SolarEnergyRacers/solar_car_control_system/data/README.md

## TODO: add description

### SER4 
// TODO

### Motor
// TODO
