SolarEnergyRacers/solar_car_control_system/data/motor/README.md

### Motor Efficiency Data

#### Naming
`xxxRyyV.csv` where `xxx=round per minutes`, `yy=voltage`

#### Torque
The test has been conducted at a constant torque of 12Nm (corresponding to approx 70km/h @ 1kW)
