SolarEnergyRacers/solar_car_control_system/docs/electroCad/README.md

# ELT-Schema and Board Design

[toc]

## Open Questions

- [ ] Do we need 5V and 3.3V on Main board?
- [ ] Should we provide additional 5V to Steering-wheel board (brightness)?
- [ ] Do we need one or two CAN bus transceivers?
- [ ] The new designed elements (PCF, ADS) and other parts need to add a footprint in library

## Rules and Hints

- all new for SER4 designed elements should get the tag "SER4"

## Main-board

### Layout Idea

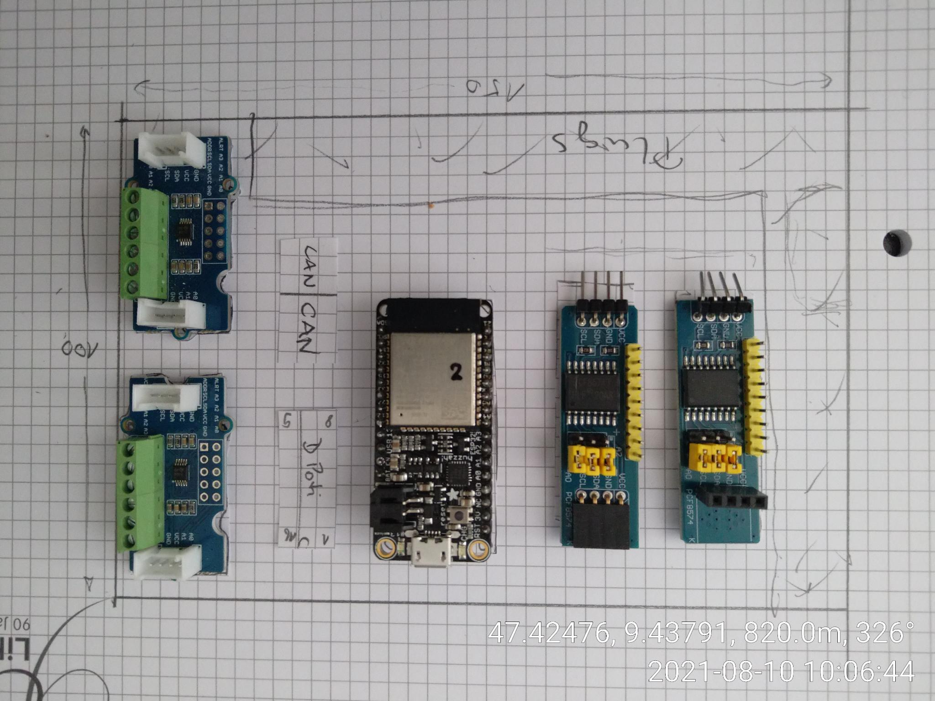
[picture p2: docs/electroCad/assets.README/mount1.png]
mount1
- Board 150x100

- --> The IO and ADC board are stripped of of all connectors and reassembled, see below) mount2

To change connectors:

- PCF8574 boards
  - remove all plugs
  - reassembly 9 pin plug (8 IOs and Interrupt) and 4 pin I2C pin (I2C) on backside
  - can possibly be shortened a little
  - drill mounting hole
- ADS1115 grove boards
  - remove all plugs and connectors
  - reassembly 4 pins (analog in) and 4 pins (I2C) on backside
- CAN
  - IC names missing in doc/data-sheets

## Steering-wheel Board
