SolarEnergyRacers/solar_car_control_system/docs/HC-12--Serial-Console.md

# HC-12 Serial Radio Console

## Description

- [Understanding and Implementing the HC-12](https://www.allaboutcircuits.com/projects/understanding-and-implementing-the-hc-12-wireless-transceiver-module/)

## Testcode

Download to both ESP32 mit connected HC-12.

```C++
#include <Streaming.h>
#include <SoftwareSerial.h>

//#define RXD 14
//#define TXD 15
#define RXD2 16
#define TXD2 17

void setup() {

  Serial.begin(115200);
  delay(1000);

  Serial << endl;
  Serial << "--------------------" << endl;
  Serial << "esp32dev + free RTOS" << endl;
  Serial << "Solar Energy Car Races SER4" << 1 << " -- " << "24.12.1924" << endl;
  Serial << "--------------------" << endl;

  Serial.println("Serial TX0 is on pin: " + String(TX));
  Serial.println("Serial RX0 is on pin: " + String(RX));

  Serial.println("Serial TX2 is on pin: " + String(TXD2));
  Serial.println("Serial RX2 is on pin:  " + String(RXD2));

  Serial2.begin(9600, SERIAL_8N1, RXD2, TXD2);
  delay(500);
  Serial2 << endl;
  Serial2 << "--------------------" << endl;
  Serial2 << "esp32dev + free RTOS" << endl;
  Serial2 << "Solar Energy Car Races SER4" << 1 << " -- " << "24.12.1924" << endl;
  Serial2 << "--------------------" << endl;

}

bool payload;
void loop() {
  payload = false;
  while (Serial2.available()) {
    Serial.print(char(Serial2.read()));
    payload = true;
  }

  String buffer = Serial.readString();

  if ( buffer.length() > 0)
    Serial2 << buffer << " -- sent!" << endl;
  delay(100);
}

```
