SolarEnergyRacers/solar_car_control_system/docs/adafruit-ltc4311-i2c-extender-active-terminator.md

# LTC4311 - I2C Extender and Active Terminator

https://learn.adafruit.com/adafruit-ltc4311-i2c-extender-active-terminator
