SolarEnergyRacers/solar_car_control_system/regulations/ReviewRegulations.md

# Review Regulations WSC, ASC

## ASC2024-Regs-EXTERNAL-RELEASE-A.pdf  (2024)
### 8.1. Sollar Collector (Jonas)
### 8.2 Energy Storage (Damian)
### 8.3 Protection Circuits (Karl)
### 8.4. Battery Ennclosures (Damian)
### 8.5. Main Fuse (Jonas)
### 8.6. Power Switch (Jonas)
### 8.7. Cables (Jonas)
### 8.8. Control (Karl)
### 8.9. Electrical Shock Hazard (Andi)

### 9.4. Lighting (Tobias)
### 9.5. E Rear Vision (Damian)
### 10.5. Breakes (Karl)

## ASC2016_Protection-System-Test-Procedure.pdf (Damian, Jonas)

## 2021_bwsc_regulations_release_version_1_19062020.pdf
### 2.4. Solar colector (Jonas)
### 2.18. Rear vision (Damian)
### 2.211 Brakes (Karl)
### 2.24 Lightinh (Tobias)
### 2.25. (Tobias)
### 2.26. (Tobias, Karl)
### 2.27. Automatic functions (Karl)
### 2.28., 2.29 Elactrical saftey, safe state (Jonas)
### 3.8. Communication (Tobias)

### 3.13. Dynamic scrutineering (alle)
