SolarEnergyRacers/solar_car_control_system/docs/ADS1115--ADC0_ADC1_ADC2-infos.md

# ADS1115: 4 Channel Analog-Digital-Converter

- [Buy: e.g. distrrelec](https://www.distrelec.ch/en/ads1115-channel-16-bit-analogue-to-digital-converter-with-programmable-amplifier-gain-seeed-studio-109020041/p/30180590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)
- [Tutorial ###TODO]()

## Pinout and Usage

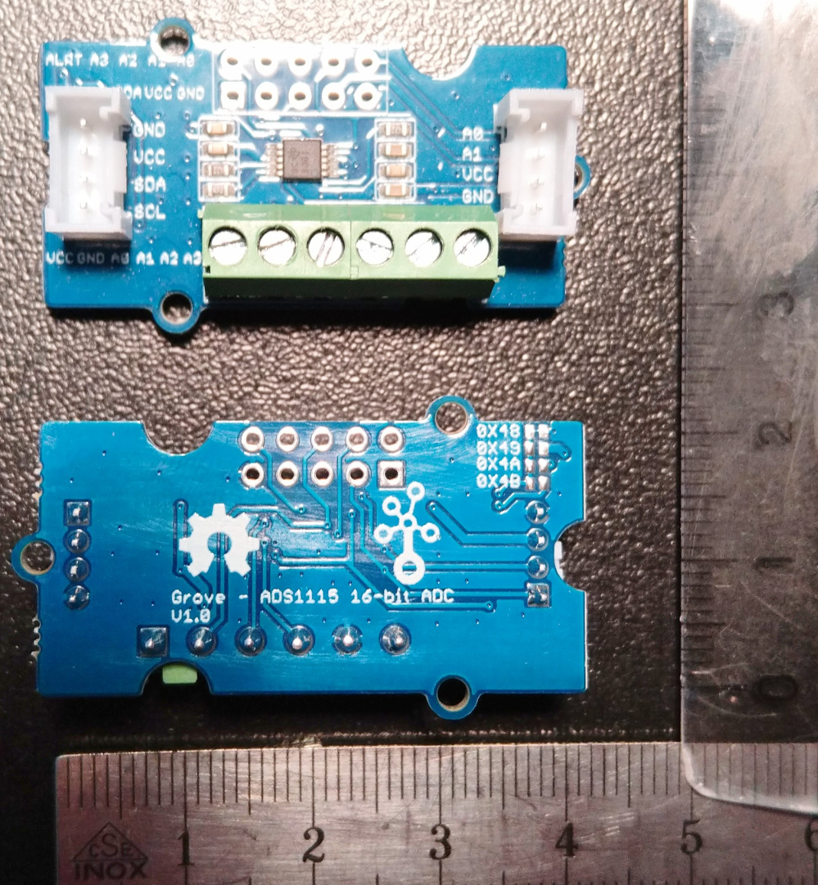
[picture p10: docs/assets.ADS1115--ADC0_ADC1_ADC2-infos/GroveADS1115-front-back.png]
GroveADS1115-front-back


Board size: 42x24, height with jumpers and plugs : 14

Usage in steering wheel:

- 2 analog in from green screw clamp (pin assignment left from screw clamp: VCC | GND | A0 | A1)
- GND, VCC from green screw clamp
- VCC, GND, SDA, SCL from plug

Usage in car hull:

- ###TODO

## Diagram

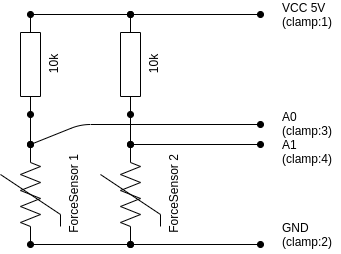
[picture p11: docs/assets.ADS1115--ADC0_ADC1_ADC2-infos/FSR-CurcuitDiagram.drawio.png]


### Board Assembly

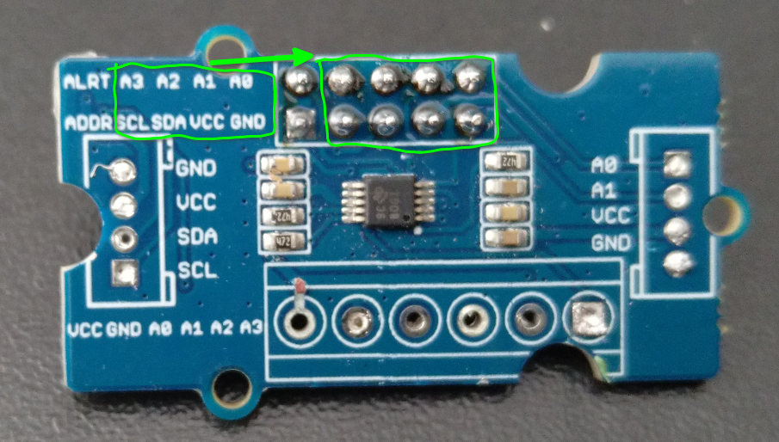
[picture p12: docs/assets.ADS1115--ADC0_ADC1_ADC2-infos/GroveADS1115-usedPins.png]


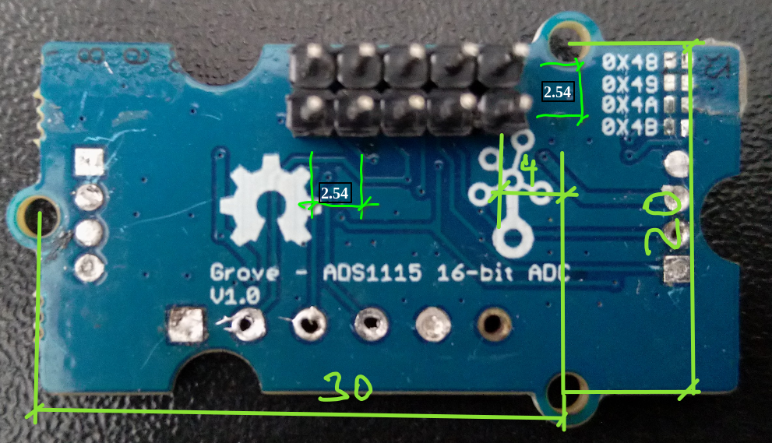
[picture p13: docs/assets.ADS1115--ADC0_ADC1_ADC2-infos/GroveADS1115-rastersize.png]


## Hints and Discussion

- [ ] May be we can desolder the screw clamp and the plugs and use smaller plugs or soldered wires
