SolarEnergyRacers/solar_car_control_system/docs/PCF8574--IOExt0_IOExt1_IOExt2-infos.md

# PCF8574: 8 bit IO Extender with Interrupt

- [Buy: e.g. amazon](https://www.amazon.de/-/en/Mountaineer-PCF8574-IO-Expansion-Expander-Development/dp/B06W564ZSD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)
- [Tutorial](https://www.instructables.com/PCF8574-GPIO-Extender-With-Arduino-and-NodeMCU/)

## Pinout and Usage

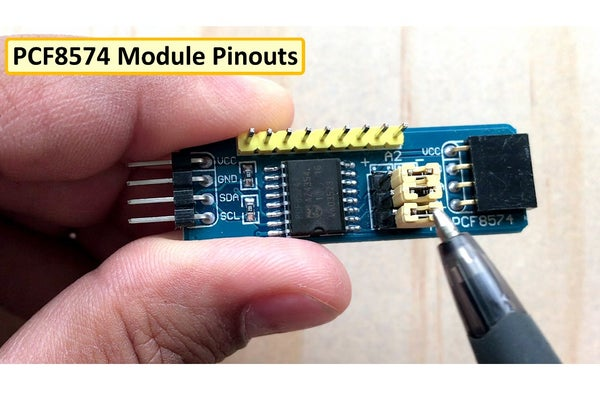
[picture p14: docs/assets.PCF8574--IOExt0_IOExt1_IOExt2-infos/PCF8574-ModulPinout.jpg]


Board size: 49x16, height with jumpers and pins : 11

Usage in steering wheel:

- 8 bits and interrupt from yellow pins (alls PCF8574 can use the same interrupt wire)
- VCC, GND, SDA, SCL from plug (chainable)

Usage in car hull:

- ###TODO

## Daisy-Chain

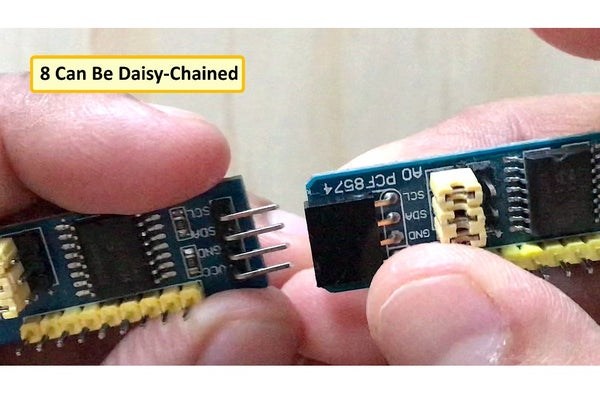
[picture p15: docs/assets.PCF8574--IOExt0_IOExt1_IOExt2-infos/PCF8574-chaining.jpg]


## Diagram

- Push buttons for steering wheel
- GND, VCC, I2C (SDA,SCL), Interrupt

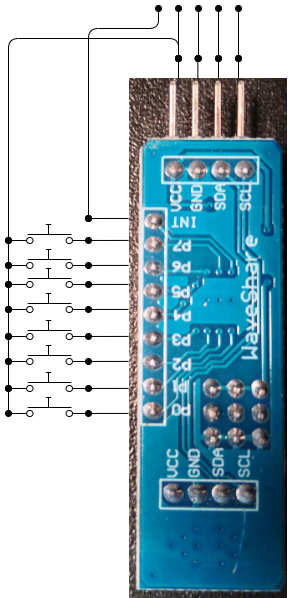
[picture p16: docs/assets.PCF8574--IOExt0_IOExt1_IOExt2-infos/IO-Ext-CurcuitDiagram.drawio.png]


### Board Assembly

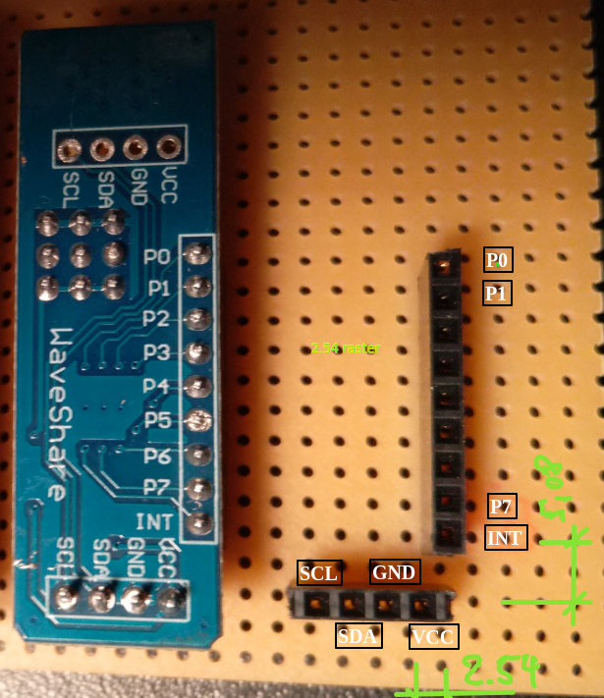
[picture p17: docs/assets.PCF8574--IOExt0_IOExt1_IOExt2-infos/PCF8574-assembly.png]
