SolarEnergyRacers/solar_car_control_system/docs/plug-infos.md

# Plugs

## Steering Wheel connector

15 pin high densitiy plugs

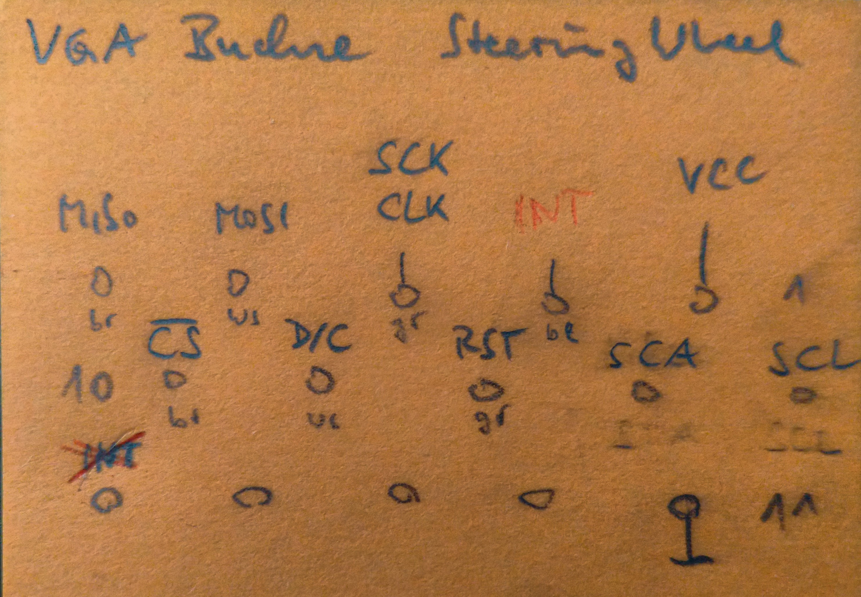
[picture p18: docs/assets.plug-infos/plug-wireing.png]
cc
