SolarEnergyRacers/solar_car_control_system/Impressions.md

# Impressions Old Cars and SER4

## Ser1 - 9m² - Dreirad

## Ser2 - 6m² - Vierrad

## Ser3 - 4m² - Vierrad

Transport
Transportation (Australia: Devils Marbles)

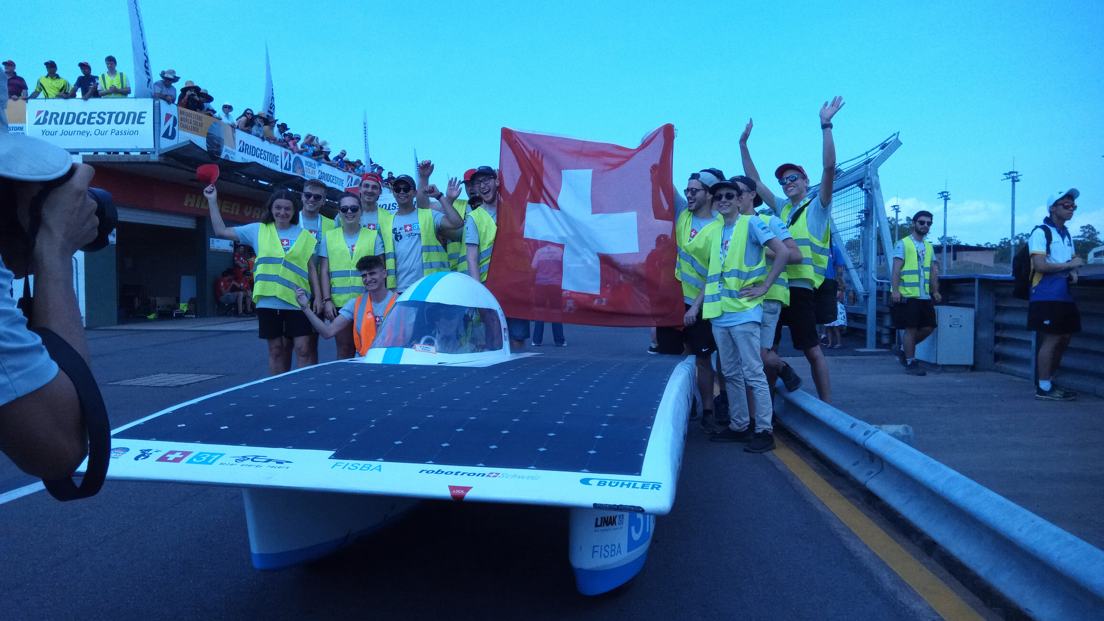
[picture p19: media/Ser3PreStart-2019-10-12.jpg]
Pre Start Peparationa

Car and some team member just before qualifying

Scruteneering
Escape from car in 12s

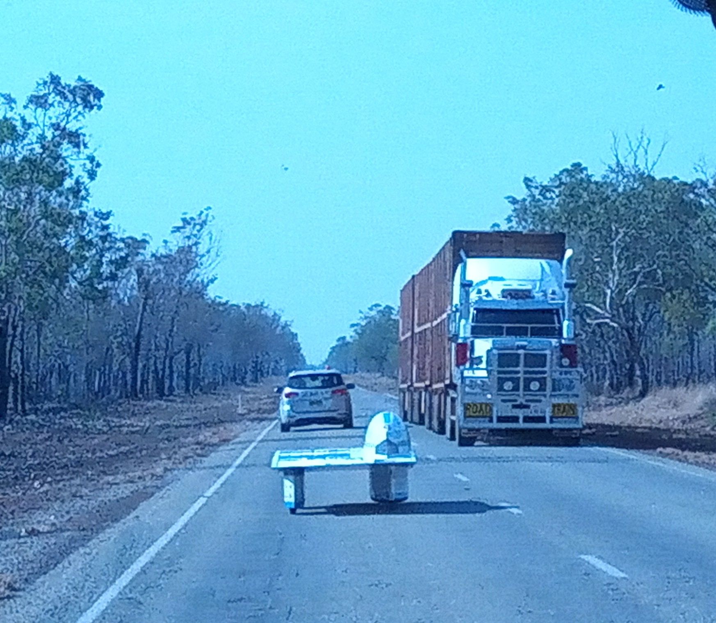
[picture p20: media/Ser3AndRoadTrain_2019-10-14.jpg]
roadTrain

Road Trains in Australia (0.16t against over 100t)

## Ser4 - 4m² - Dreirad

![]()

![]()
