SolarEnergyRacers/solar_car_control_system/docs/assets.DOCU--ILI934-MCP230176-ESP32-Hazzy/ILI9341-wired-fliped.png

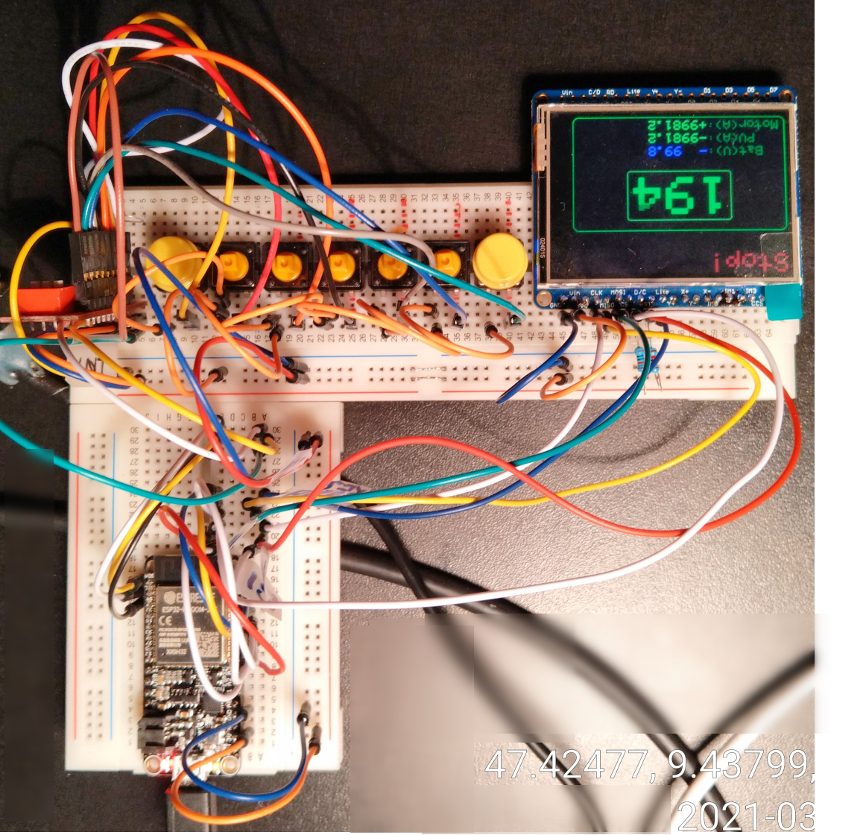
docs/assets.DOCU--ILI934-MCP230176-ESP32-Hazzy/ILI9341-wired-fliped.png
