SolarEnergyRacers/solar_car_control_system/docs/electroCad/signal-2022-05-11-184520_001.jpeg

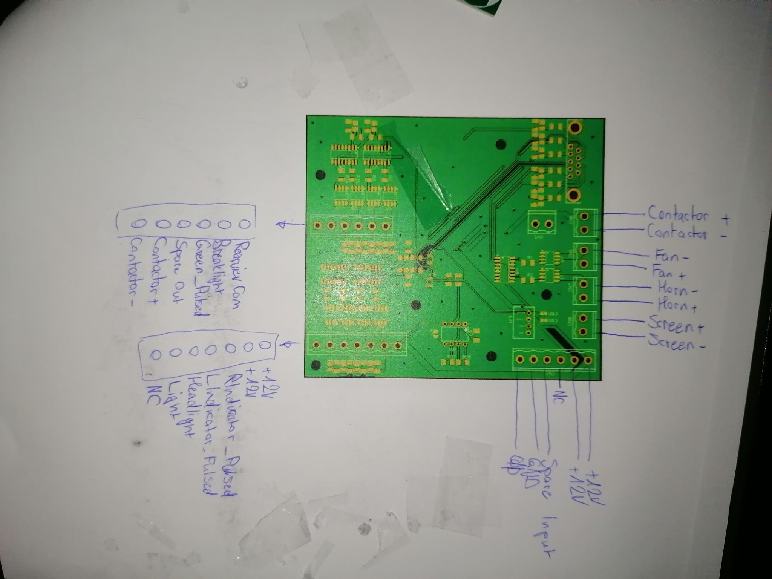
docs/electroCad/signal-2022-05-11-184520_001.jpeg
