SolarEnergyRacers/solar_car_control_system/docs/ser4-drivers-manual.md

# SER4 Drivers Manual

## Preparation

## Control Elements

### Mainboard

(nothing to do by the driver)

### Emergency Controls

### Switch Board

### Steering Wheel

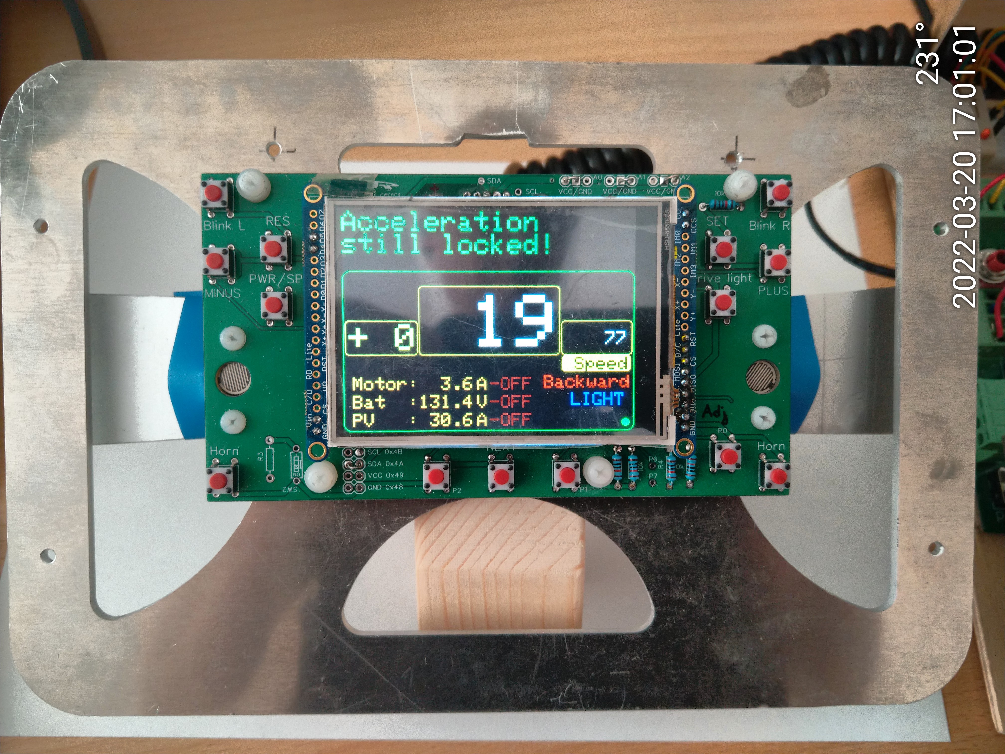
[picture p23: docs/assets.ser4-drivers-manual/SteeringWheel-22022.03.20.jpg]
steeringwheel


## Car Start

### Boot Screen

The bootscrren with blue font on yellow background shows the initialisation of all devices controlled by the car control system.

The first part shows the device init, the second part shows the control task creation.

The last display is a 4 Seconds countdown to allow an additional view to the values.

### Adjust Paddles

After each start the Paddles must be adjusted. Until that the acceleration is locked. It is shown by the number `-99` in the `acceleration/deceleration` display and the drivers information Acceleration still locked.

Procedure:

- Press Button `ADJ`
- Move both paddles at same time slow from min to max to min.
  You have about 5s time for that.
- If successful the `acceleration/deceleration` display show `+ 0`
  Otherwise repeat the complete procedure

## Car Operate

## Steering Wheel

### Buttons

### Paddles

### Display
