SolarEnergyRacers/solar_car_control_system/test/u-i-diagrams.ods

Spannung [V] | Strom Black [mA] | Strom White [mA] | Leistung Black[mW] | Leistung White [mW]
3.05 | 25 | 24 | 75 | 72
3.3 | 30 | 29 | 99 | 96
3.8 | 54 | 53 | 205 | 201
4 | 63 | 62 | 252 | 248
5 | 83 | 80 | 415 | 400
