SolarEnergyRacers/solar_car_control_system/(threads)

Thread 1 (2021-02-02):

Add UART support

andreaskuster, 2021-02-02:
Doc about ESP32 UART module: https://docs.espressif.com/projects/esp-idf/en/v4.0/api-reference/peripherals/uart.html

We might want to use [SoftwareSerial](https://www.arduino.cc/en/Reference/softwareSerial) instead? (simpler interaction)

andreaskuster, 2021-04-12:
The ESP32 equivalent to SoftwareSerial is: https://github.com/jdollar/espsoftwareserial

Closed 2021-04-18.

Thread 3 (2021-02-02):

Add SPI support

andreaskuster, 2021-02-02:
Doc about the ESP32 SPI modules: https://docs.espressif.com/projects/esp-idf/en/v4.0/api-reference/peripherals/spi_master.html

andreaskuster, 2021-02-05:
SPI is supported through the [arduino spi library](https://www.arduino.cc/en/Reference/SPI) on pins
```
 * ESP32 SPI
 *
 *  ESP32  - SPI Pin
 *  --------------
 *  VSPI
 *  GPIO23   MOSI
 *  GPIO19   MISO
 *  GPIO18   CLK
 *  GPIO5    CS (first device, can be any GPIO)
 *
 *  HSPI
 *  GPIO13   MOSI
 *  GPIO12   MISO
 *  GPIO14   CLK
 *  GPIO15   CS
```

Closed 2021-02-05.

Thread 4 (2021-02-02):

Add CAN support

andreaskuster, 2021-02-02:
Doc about ESP32 CAN module: https://docs.espressif.com/projects/esp-idf/en/v4.0/api-reference/peripherals/can.html
Library we might want to use: https://github.com/miwagner/ESP32-Arduino-CAN
**Integrate it into Solar-Car-Control-System**

andreaskuster, 2021-09-01:
The CAN setup has been tested to work using `USB-CAN Adapter` (Profinity & microbus) as well as using the `MCP2521 SPI-CAN Adapter` to interface with a MCU (the ESP32 internal CAN hardware hasn't been tested, but should be supported by the library I used i.e. [arduino-CAN](https://github.com/sandeepmistry/arduino-CAN)

However, what is still missing is the correct configuration / assignment of the CAN IDs. This can only be done with Profinity in conjunction with the `USB-Ethernet Bridge`

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

andreaskuster, 2021-09-06:
Basic support has been added.

andreaskuster, 2021-10-03:
@garned
TODO:
- test CAN with MPPT trackers as well
- add software part to decode data packets
-

andreaskuster, 2022-01-11:
Resolved #131

Closed 2022-01-11.

Thread 7 (2021-02-02):

Add ADS1x15 (analog to digital converter) support

andreaskuster, 2021-02-02:
Port libary: https://github.com/adafruit/Adafruit_ADS1X15

andreaskuster, 2021-02-03:
Initial portation done (it works). Some cleanup work as well as making the i2c read/writes thread-safe remains.

Closed 2021-02-03.

Thread 8 (2021-02-02):

Add DS18B20 (1-Wire temperature sensor) support

andreaskuster, 2021-02-02:
Port library: https://github.com/matmunk/DS18B20

andreaskuster, 2021-02-03:
Initial portation done (it works). Some cleanup work as well as making the 1-Wire read/writes thread-safe remains.

Closed 2021-02-03.

Thread 15 (2021-02-03):

Add PCA9685 (16x 12bit PWM output) support

andreaskuster, 2021-02-03:
Port library: https://github.com/adafruit/Adafruit-PWM-Servo-Driver-Library

andreaskuster, 2021-02-03:
The library has been ported and tested. Some cleanup and ensure thread-safety remains.

Closed 2021-02-03.

Thread 17 (2021-02-03):

Add Grove 6 axis accelerometer & gyroscope support

andreaskuster, 2021-02-03:
Port library: https://github.com/Seeed-Studio/Grove_6Axis_Accelerometer_And_Gyroscope_BMI088

andreaskuster, 2021-02-03:
Initial implementation added and tested.

Closed 2021-02-03.

Thread 24 (2021-02-06):

Define final steering wheel layout (inputs / outputs, potentiometers, ..)

andreaskuster, 2021-02-06:
Discussion done, @KarlSchu can you add the steering wheel layout to this repo (and than close this issue)?

Closed 2021-05-16.

Thread 29 (2021-04-06):

Build pipeline is broken

andreaskuster, 2021-04-06:
Problem: The build fails since the dependent branch `idf-release/v4.0` in `https://github.com/espressif/arduino-esp32.git` in https://github.com/SolarEnergyRacers/solar_car_control_system/blob/7639e751cd04a7a1949b778afc328082f6fe04fd/platformio.ini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
has been delete.

Temporary fix: I was able to get fetch the branch through a closed PR: https://github.com/espressif/arduino-esp32/pull/3670
and temporarly serve this files from https://github.com/andreaskuster/arduino-esp32.git#idf-release/v4.0

Closed 2021-04-06.

Thread 36 (2021-04-09):

Circuit boards V2

andreaskuster, 2021-04-09:
TODO:
- ADC: address issue (@KarlSchu )
- IOExt: alternative IC (@KarlSchu )

- labelling: add input/output label (@DAKOFPV )

andreaskuster, 2021-10-03:
Version1: done
Updated version:
- 2 CAN bus plugs (1x MPPT, 1x BMS) for independent plugin

Closed 2021-12-23.

Thread 40 (2021-04-11):

Fix CAN Problems!!!

tomajon1, 2021-04-11:
Write Email to Prohelion

User Manual:
"COMMUNICATIONS
The CAN standard does not specify high-level message protocols. Prohelion devices use a
custom protocol, outlined in the communication specification document for each device.
By default, each device operates at 500 kbits/second and comes programmed from the factory
with a CAN base address that will allow it to work in unison with other Prohelion devices. The
CAN bit rate and base address can be set with the Windows BMS configuration software."

tomajon1, 2021-04-12:
Hi Jonas,

This functionality is not yet in Profinity, you will need to use the old Tritium tools.

Make sure you get the latest versions of BMS Viewer and CAN-Ethernet bridge configuration:

 BMS_Viewer_2_00.exe
 CanBridgeConfigInstaller_2_04.msi

If you run the BMS viewer software:

1.	Setup->BMS Configuration
2.	Change CAN Bitrate to desired rate:

3.
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

4.	Then: Transfer->Save to BMU

The BMU is now running on the new rate but you will have now lost communications so will need to change the rate on the CAN Bridge:

Go to CAN-Ethernet Bridge Configuration:
5.	Change Bit Rate

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

Hit:  Store

And you should now be communicating on the same bitrate.

Kind regards,

Anthony Prior
CEO
M: +61 411 098 131

andreaskuster, 2021-04-25:
@Damian:

(1) read datasheet
(2) set bitrate to 125k
(3) get it working :)
- possible solution: twisted-pair cable
- oscillator debugging

tomajon1, 2021-07-13:
CAN-Ethernet Bridge Configuration does not work on Windows 7

andreaskuster, 2021-09-06:
Solved & PR created.

Closed 2021-09-06.

Thread 52 (2021-04-25):

#### Isolatation between MCU and external HW

andreaskuster, 2021-04-25:
We should add some sort of isolation between the microcontroller and the external component i.e. to prevent damages of the MCU from short circuits/overvoltage, ..

andreaskuster, 2021-05-30:
This? https://www.ti.com/store/ti/en/p/product/?p=TPS25921LD

Thread 57 (2021-05-10):

check if CS of driver display is at the correct processor pin (may be read only)

KarlSchu, 2021-05-10:

Closed 2021-12-23.

Thread 63 (2021-05-16):

Add Ubat voltage sensing

andreaskuster, 2021-05-16:

andreaskuster, 2021-05-16:
Fixed with PR #64

Closed 2021-05-16.

Thread 65 (2021-05-16):

Fix pin conflict: interrupt / CAN

andreaskuster, 2021-05-16:

Closed 2021-10-03.

Thread 67 (2021-05-16):

Setup online prototype: laptop + prototype ESP32 with all parts mounted + teamviewer + camera on

andreaskuster, 2021-05-16:
```
           xxxxxxx
          xx       xx   xxxx
         xx         xxxx   xx
        xx          x      xxxxxxxx
xxxxxxxxx                          xxx
x      xx                             xxx
x                                       xx
xx                www                    x
 xx                                    xxx
  xxxx x                        xxxx xxx
      xxxxxxxxxxxxxxxxxxxxxxxxxxx
       │                                             ┌─────► ┌─────┐
       │                                             │       │     │
   WiFi│                                             │ ┌───► │ HW  │
       │                                             │ │     │     │
       │        PC                                   │ │ ┌─► └─────┘
    ┌──┴───┬───────────┬─────────┐                   │ │ │
    │      │           │         │ ┌────►     ┌──────┴─┴─┴───┐
    │      │           │  Webcam │ │────►     │              │
    │      │           │         │ └────►     │              │
    │ Team │           └─────────┤            │    ESP32     │
    │ viewer      ┌───┐ ┌──────┐ │    USB     │              │
    │      │      |git|+|vscode├─├────────────┤              │
    │      │      └───┘ └──────┘ │            └──────────────┘
    │      │                     │
    │      │                     │
    │      │                     │
    └──────┴─────────────────────┘

```

andreaskuster, 2021-07-04:
@garned @tomajon1 @KarlSchu @DAKOFPV
Whoever is next at BUZ can either try to install the firefox & gecko webdriver, and adjust the script to catch the login html elements:
- https://github.com/SolarEnergyRacers/solar_car_control_system/blob/add_captive_auto_login/extras/automation/captive_portal.py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
- https://github.com/SolarEnergyRacers/solar_car_control_system/blob/add_captive_auto_login/extras/automation/captive_portal.py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
- https://github.com/SolarEnergyRacers/solar_car_control_system/blob/add_captive_auto_login/extras/automation/captive_portal.py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

in the sbb login template, or send me the HTML copy and urls/IPs of the page.

Closed 2021-12-27.

Thread 71 (2021-06-13):

Battery charging

tomajon1, 2021-06-13:
[2021_06_08_iESC_Regulations_release_version_1-1.pdf](https://github.com/SolarEnergyRacers/solar_car_control_system/files/6644346/2021_06_08_iESC_Regulations_release_version_1-1.pdf)

Pages: 19-22 Weight cells and charging
Page: 38 Auxilary battery

Idea:
- from BMS: cable that can trigger  external circuit breaker while charging

- new power supply & charge controller over full system voltage -> use BMS for balancing

--> akt.Stand: 12V-Steuerspannungsrelais schaltet Schütz1 mit 24 Volt, welches das 400V Schütz2 mit  ansteuert

tomajon1, 2021-06-13:
[2021_06_08_iESC_Regulations_release_version_1-1.pdf](https://github.com/SolarEnergyRacers/solar_car_control_system/files/6644343/2021_06_08_iESC_Regulations_release_version_1-1.pdf)
Pages: 19-22 Weight cells and charging
Page: 38 Auxilary battery

Closed 2021-09-12.

Thread 72 (2021-06-17):

Electronic Component Placement (within the Car)

andreaskuster, 2021-06-17:
#### SER-4 Montage Steuerung/Elektrik

Könnt Ihr mal skizzieren, wo Ihr welche elektrischen Komponenten montieren wollt,
und welches mechanische Montagematerial Ihr dafür benötigt (Alu-Flanche u.ä.)

Besten Dank !

garned, 2021-06-20:
Erster Vorschlag:
MC links aussen an den Längsträger und der uC auf die gegenüberliegende Innenseite.

KarlSchu, 2021-06-20:
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

Closed 2021-06-28.

Thread 83 (2021-07-18):

Green position light if car is in uncritical state

KarlSchu, 2021-07-18:

andreaskuster, 2021-08-07:
@KarlSchu
We might even want to go a step further:
- green: ok
- orange/red: problem, maybe a blink code (i.e. for standard issues like over temparature/current/..)

Thread 84 (2021-07-28):

Discuss Singletons in C++:

KarlSchu, 2021-07-28:
static DriverDisplayC *instance() {
    if (!_instance) {
      _instance = new DriverDisplayC();
    }

-> refactor to `extern` & global definition

andreaskuster, 2021-08-07:
@KarlSchu
Any pros/cons?
As far as I can see, this structure only works with a single class instance, right? Is that a problem?

Closed 2021-12-23.

Thread 94 (2021-08-15):

Battery Status Information

andreaskuster, 2021-08-15:
- what information do we need/want on the microcontroller charging screen? (i.e. temp/min,max voltage,...

Closed 2021-09-12.

Thread 99 (2021-08-29):

Zweiter Bildschirm (Laden)

KarlSchu, 2021-08-29:
- PV-Status [On/Off]
- Batt - Status [Ok, Error]
- BMS-Fehler: <text>

- MPPT 1 -3 [A]

- Batterietemp 1-4 [°C], Höchste T [°C]
- Spannungen min, average, max [V]
- Gesamtspannung Batterie
- Strom BMS [A]

Closed 2021-11-14.

Thread 103 (2021-09-05):

Where are the Temp sensors placed?

KarlSchu, 2021-09-05:
- Solarcells (4 parts)
- MotorController (1)
- MPPTs (4 parts)
- Battery are supported from BMS
- ???

Closed 2022-01-30.

Thread 110 (2021-10-16):

Exchange IOExt chip in SW

KarlSchu, 2021-10-16:
a bit nasty right now -> need to have old IOExt (steering wheel) and new one active at the same time)

andreaskuster, 2021-12-27:
@KarlSchu this is done with the newest merged PRs, right?

Closed 2022-01-02.

Thread 111 (2021-10-16):

Add Gyro functions

KarlSchu, 2021-10-16:

andreaskuster, 2022-03-29:
As far as I can see, the gyro and accelerometer are already integrated (only the `CarState` transition is missing), right?

So, is there anything I should do here?

andreaskuster, 2022-03-31:
The was a deadlock present in the library, which has been fixed while refactorization.

Closed 2022-03-31.

Thread 118 (2021-10-26):

Fix SPI two devices initialization error

andreaskuster, 2021-10-26:
-> spi multiplexer?

andreaskuster, 2021-12-27:
Resolved, the issue was a pin placement and some hardware issues (with the integrated SD card slot in the screen, it works)

Closed 2021-12-27.

Thread 125 (2021-12-05):

Adjust analog outputs: use 0 to 1024 (0V - 5V)

KarlSchu, 2021-12-05:
Use full ADC range: 0 to 1024 (0V - 5V)
For paddles: adjust to paddle range to get 0-5V at acceleration (Speed) and recuperation

andreaskuster, 2022-01-02:
see #140

Closed 2022-02-06.

Thread 134 (2021-12-30):

Physically change GPIO36 (input only, but used as an output!!) -> GPIO32

KarlSchu, 2021-12-30:
In the current branch is a changelog.mf file where the changes are described.
Please check "solved" box if overtraken into  electro schema.

@DAKOFPV:
https://github.com/SolarEnergyRacers/solar_car_control_system/blob/feature/adjust-ios/CHANGELOG_HW.md

Closed 2022-01-30.

Thread 135 (2021-12-30):

fix not working acceleration output

KarlSchu, 2021-12-30:
while dec works the acc gives no value: check circuit for break pedal relais

see #140

Closed 2022-01-30.

Thread 136 (2021-12-30):

Fix sporadic Error

KarlSchu, 2021-12-30:
[E][esp32-hal-i2c.c:1438] i2cCheckLineState(): Bus Invalid State, TwoWire() Can't init sda=1, scl=1

andreaskuster, 2021-12-30:
@KarlSchu Maybe pullups would to the trick, see: https://github.com/espressif/arduino-esp32/issues/3079

Thread 138 (2021-12-31):

Speed control should use acceleration and deceleration

KarlSchu, 2021-12-31:
Recently only acceleration is used in speed control PID

-> on hold until battery is ready (for recuperation part)

andreaskuster, 2022-01-02:
Idea:
Add a meta-variable for the PID controller `setpoint`

Pseudocode:
```
if (decelleration > 0){
   setpoint=  - deceleration
} else {
   setpoint = acceleration
}
```

andreaskuster, 2022-01-06:
@KarlSchu I assume this PR  #144 implements what you are looking for?

andreaskuster, 2022-04-08:
Resolved with #173

Closed 2022-04-08.

Thread 139 (2022-01-01):

Review system boot: All devices off after boot!

KarlSchu, 2022-01-01:

andreaskuster, 2022-03-29:
For all non-critical devices, calling the `init()` function should be enough, right?

And for the safety-critical functions: Aren't we doing this `watchdog timer` thing yet? Sure, the intention was for micro controller crashes, but we should get this additional functionality for free, right?

Thread 142 (2022-01-02):

Telemetry Xbee module SW integration

andreaskuster, 2022-01-02:
-> maybe SD card there? no, problem solved with SD+Display

-> Can we use XBee as Serial console? yes, we will do this!

@garned
TODO:
- test uart tranceiver
- range-test

Closed 2022-02-20.

Thread 145 (2022-01-09):

###### Add voltage sensing at cross point (battery, MC, MPPT) via resistor bridge to ADC

KarlSchu, 2022-01-09:
-> for green light indicator
-> mount on external PCB (high voltage) -> Remo

andreaskuster, 2022-01-16:
Also assigned to @Remo

Thread 154 (2022-02-06):

fix BM088 Gyro&Acc interference with other i2c devices

andreaskuster, 2022-02-06:

andreaskuster, 2022-03-28:
@KarlSchu I re-assigned you, since I do not have the whole board and thus cannot reproduce/test it

Thread 156 (2022-02-12):

Show const speed/power in Driver display

KarlSchu, 2022-02-12:
- at const mode on speed and power are measured in stored
- at switch between speed/power mode the speed/power value is measured and the power/speed reset to 0
- at const mode off speed and power are reset to 0

Closed 2022-03-28.

Thread 166 (2022-02-15):

Integrate HC-12 radio module

KarlSchu, 2022-02-15:

andreaskuster, 2022-02-15:
@KarlSchu
A little present for you:
(1) UART Tx/Rx must be twisted on both sides (i.e. Rx <-> Tx and vice versa)
(2) The SET pin must be floating
(3) It is actually pretty easy to use multiple Serial instances in parallel, see code below (for the receiver)
```
#define RXD2 16
#define TXD2 17

void setup() {
  // Note the format for setting a serial port is as follows: Serial2.begin(baud-rate, protocol, RX pin, TX pin);
  Serial.begin(115200);

  Serial2.begin(9600, SERIAL_8N1, RXD2, TXD2);

  Serial.println("Serial TX0 is on pin: "+String(TX));
  Serial.println("Serial RX0 is on pin: "+String(RX));

  Serial.println("Serial TX2 is on pin: "+String(TXD2));
  Serial.println("Serial RX2 is on pin: "+String(RXD2));

}

bool payload;
void loop() {
  payload = false;
  while (Serial2.available()){
    Serial.print(char(Serial2.read()));
    payload = true;
  }

  if(!payload){
      Serial.println("Nothing to process");
  } else {
      Serial.println();
  }
  delay(5000);
}
````

andreaskuster, 2022-02-20:
Notes:
- continuous 5V supply ??
- capacitor on tx side

Thread 184 (2022-04-24):

Ser1 motor cable shorten.

KarlSchu, 2022-04-24:
New plug for data cable.

Thread 186 (2022-05-15):

Gyro Vibrations?

KarlSchu, 2022-05-15:

Thread 192 (2022-06-05):

Redraw PCBs (i2c issues)

garned, 2022-06-05:
