SolarEnergyRacers/solar_car_control_system/docs/Schematic_SER_Main_2021-09-28.pdf

# + SD Card reader

# + RTC

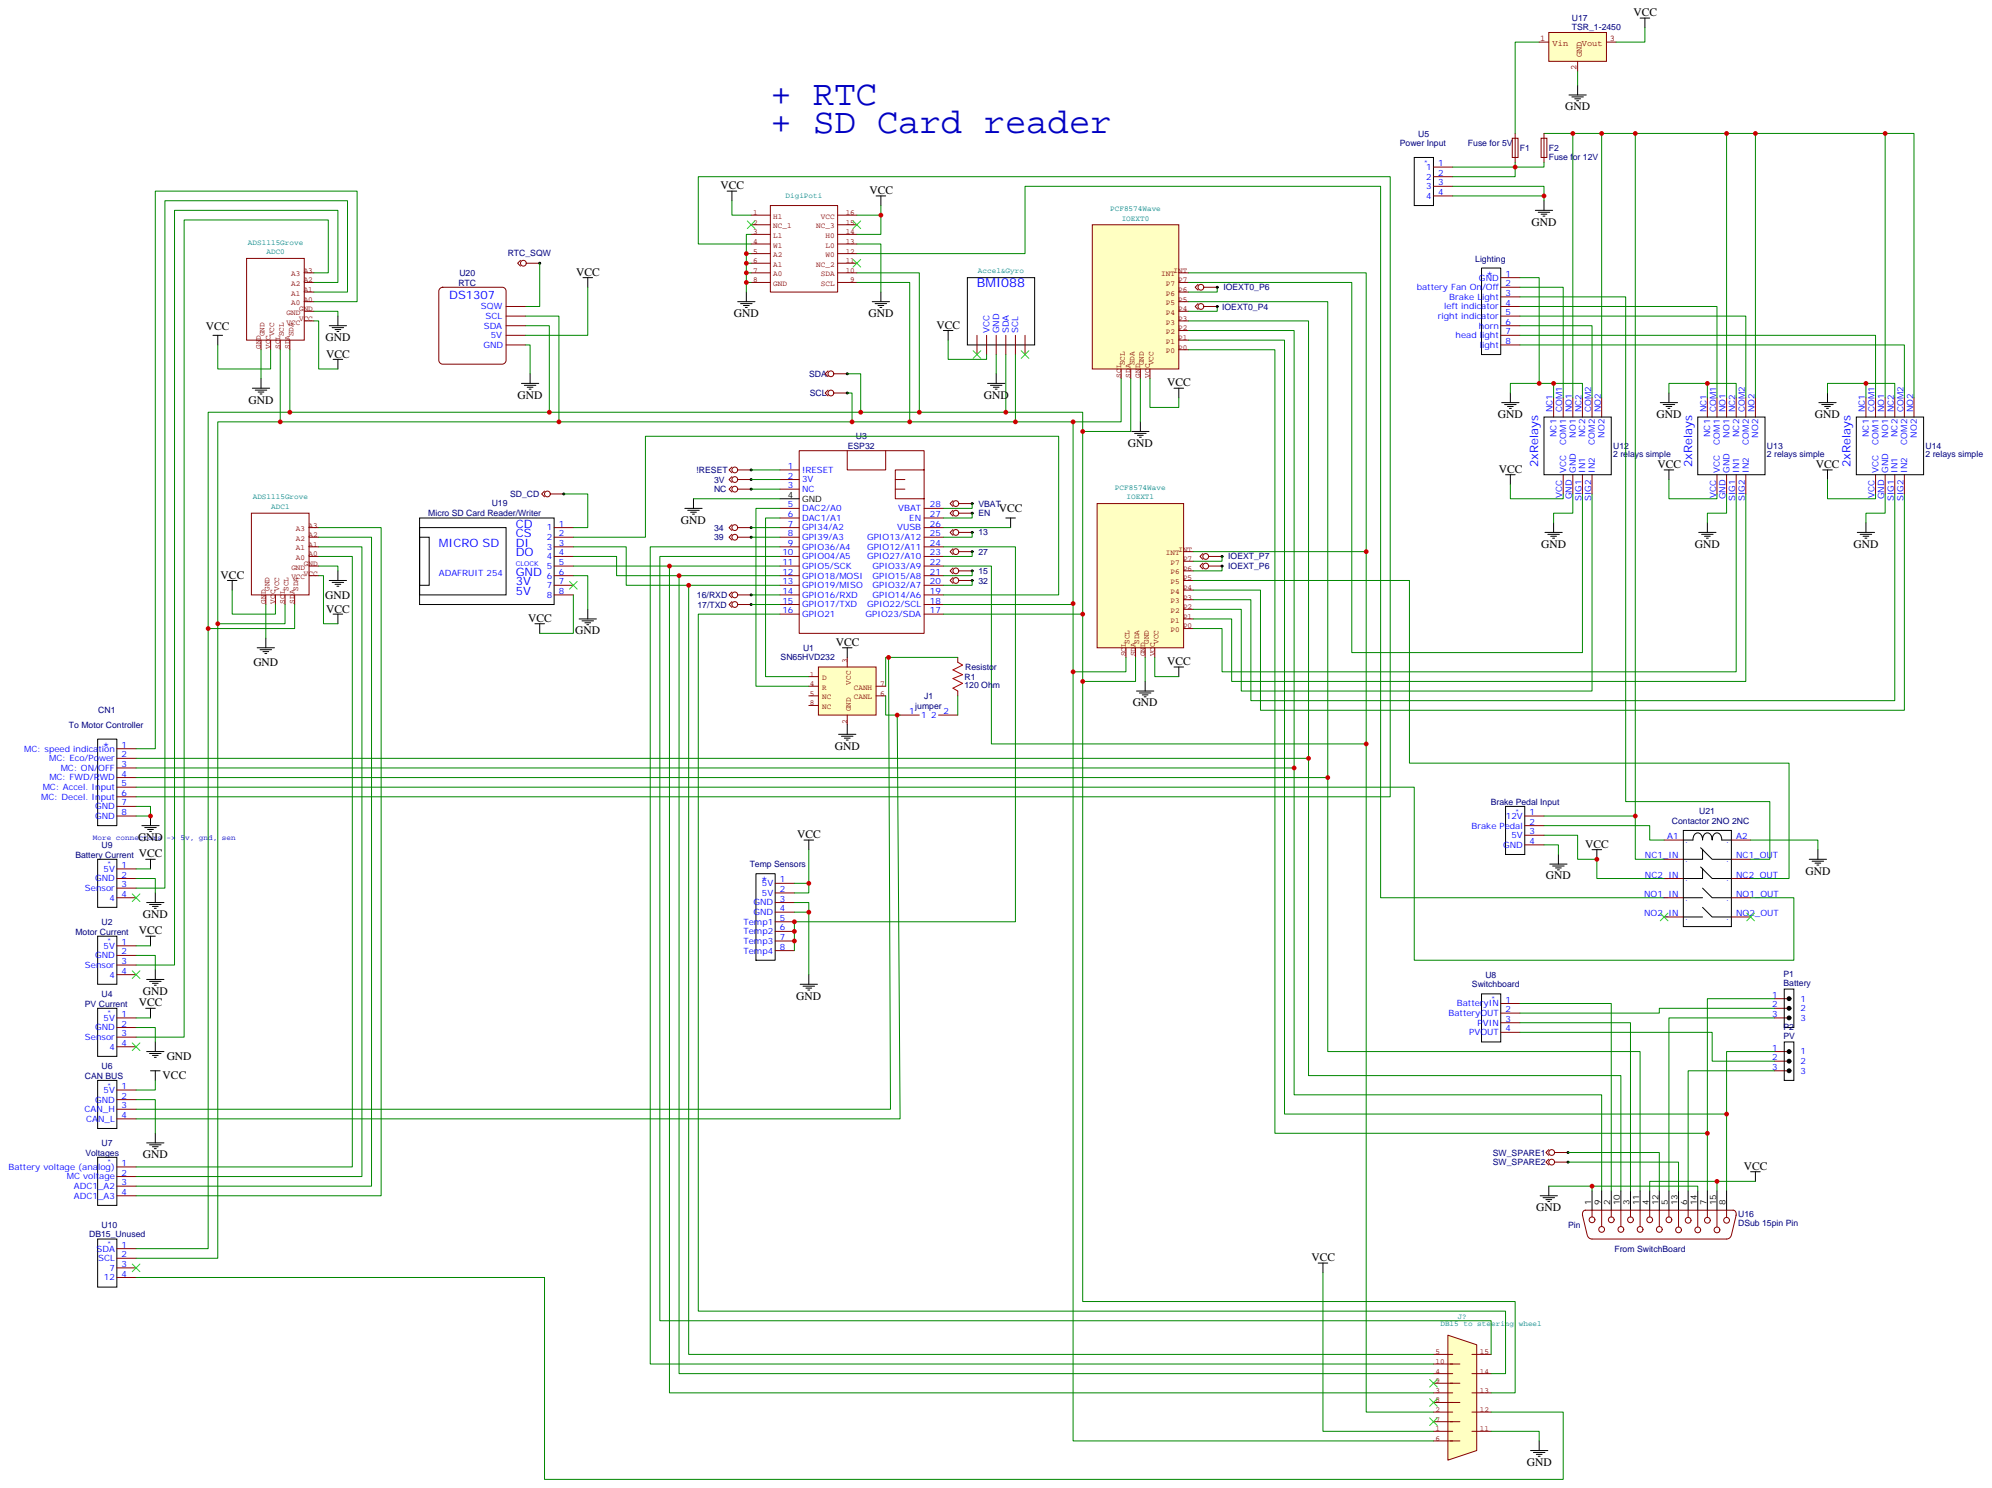
[picture p24: page 1]

battery Fan On/Off
left indicator
right indicator
head light

Micro SD Card Reader/Writer
