SolarEnergyRacers/solar_car_control_system/docs/Schematic_SER_Steeringwheel_2021-09-28.pdf

## IOEXT1

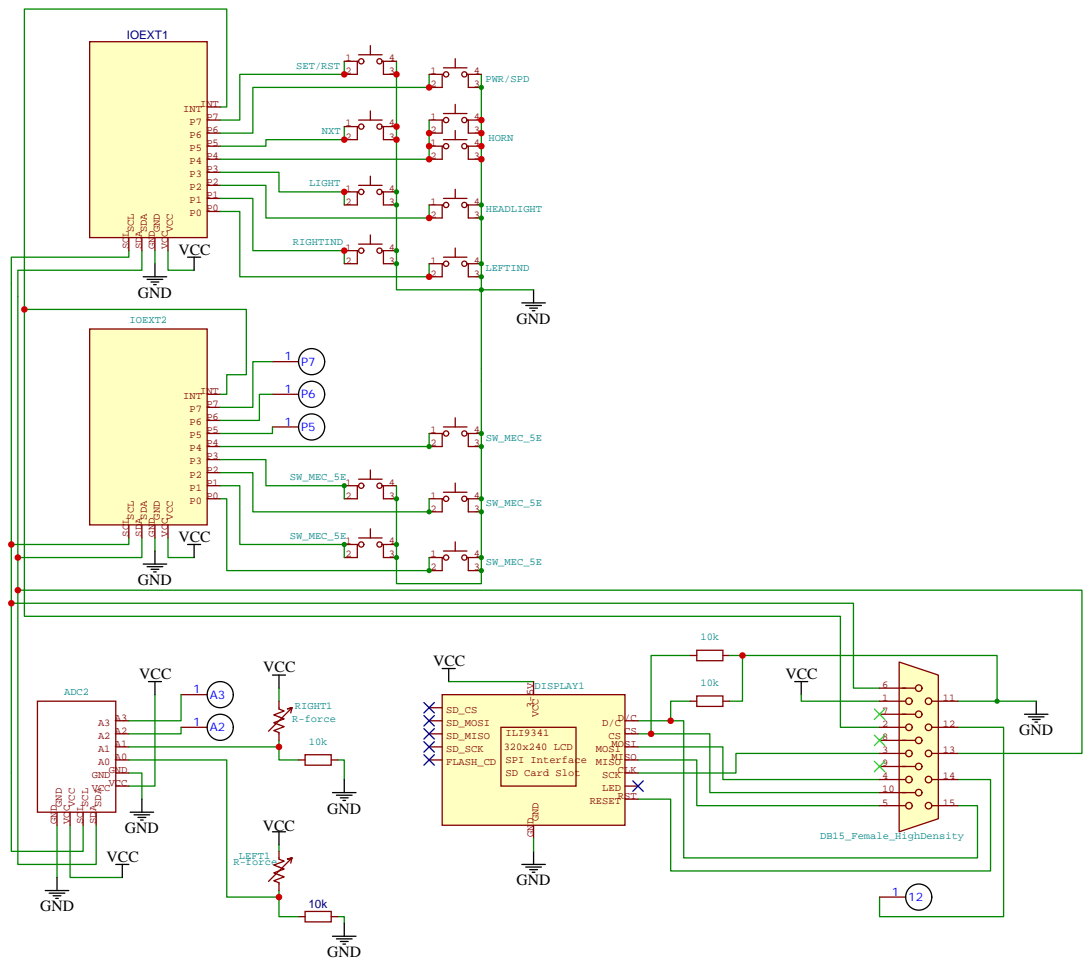
[picture p26: page 1]
