SolarEnergyRacers/solar_car_control_system/(list of files, drawings)

Other design files:
docs/electroCad/SCH_SER_Main_2021-08-20.json
