SolarEnergyRacers/solar_car_control_system/docs/electroCad/ser4.kicad_pcb

## KiCad design docs/electroCad/ser4.kicad_pcb (2021-08-15)

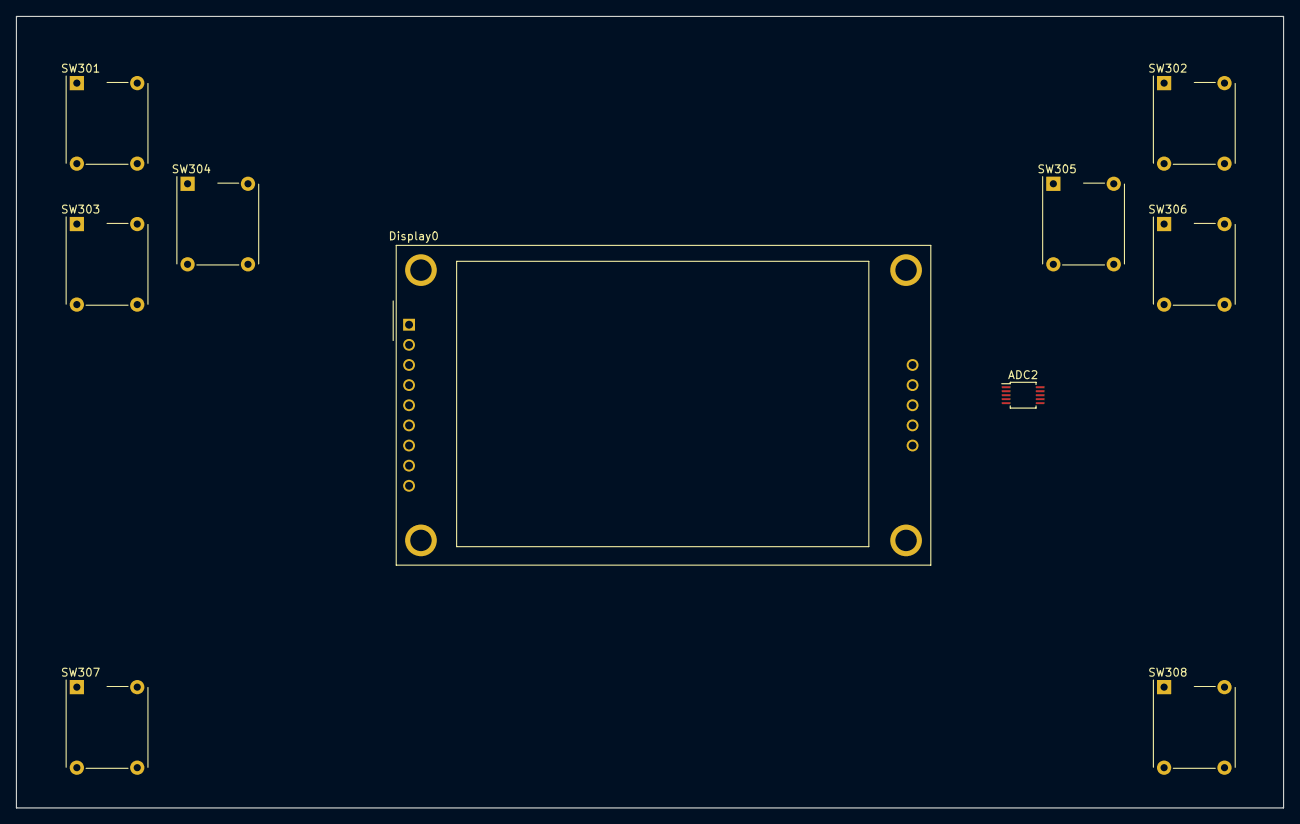
[picture p27: board ser4.kicad_pcb from above]

Board: 2 copper layers, 159.8 x 99.8 mm, 10 parts (0 on the bottom side), 10 nets, no tracks yet.

Parts:
ADC2: ADS1115IDGS; TSSOP-10_3x3mm_P0.5mm
Display0: CR2013-MI2120
SW301, SW302, SW303, SW304, SW305, SW306, SW307, SW308: SW_MEC_5E; SW_MEC_5GTH9

Connections:
GND: ADC2.3, Display0.2
unnamed: SW301.1, SW301.2
unnamed: SW302.1, SW302.2
unnamed: SW303.1, SW303.2
unnamed: SW304.1, SW304.2
unnamed: SW305.1, SW305.2
unnamed: SW306.1, SW306.2
unnamed: SW307.1, SW307.2
unnamed: SW308.1, SW308.2
VCC: ADC2.8, Display0.1
