SolarEnergyRacers/solar_car_control_system/include/CarStatePin.h

//
// Car State Pins
//

#ifndef CARSTATEPIN_H
#define CARSTATEPIN_H

#include <definitions.h>

using namespace std;

class CarStatePin {
public:
  int port; // high nibble: device number, low nibble: portNr (pin)
  int mode;
  int value;
  int oldValue;
  bool inited;
  long timestamp;
  string name;
  void (*handlerFunction)();
};

#endif // CARSTATEPIN_H
