SolarEnergyRacers/solar_car_control_system/(commit log)

2021-02-02 Add basic FreeRTOS project (with Arduino library integration for simpler library porting). #5
2021-02-02 Add PlatformIO ESP32 dev configuration (including online jtag debugging). #12
2021-02-02 Outsource physical pin mapping into separate header.
2021-02-02 Replace pinmap file with more generic definitions file.
    [definitions.h]
2021-02-03 Init i2c bus externally #7.
2021-02-03 Add i2c and adc init and example periodic task #7.
2021-02-03 Add 1-Wire helper library #8
2021-02-03 Add device monitoring (serial output) to command list.
2021-02-03 Port and include grove gyro and acc library #17.
2021-02-03 Adjust output log to scheme `[device] message`.
2021-02-03 Add initial library port for the PCA9685 PWM output board #15.
2021-02-03 Add polling routine for the PCA9685 PWM output board #15.
2021-02-03 Replace local ADS1x15 library with externally managed library (for better compatibility and updates).
    [main.cpp]
2021-02-03 Replace local DS18B20 library with externally managed library (for better compatibility and updates).
    [main.cpp]
2021-02-03 Replace local PCA9685 with external platformio include.
    [main.cpp]
2021-02-04 Add arduino version build flag.
2021-02-04 Replace platformio BM088 library (not compatible with ESP32 environment) with manual port.
    [main.cpp]
2021-02-04 Fix missing ARDUINO version definition for release builds.
2021-02-04 Add sd card support #16. Add gpio pin interrupt handler #6 Add macro to (de-)activate functionality.
2021-02-04 Add gpio interrupt pin definition #6
2021-02-05 Add device datasheets #10.
2021-02-05 Add thread-safety functionality (mutex) to i2c bus implementations #10.
2021-02-05 Refactor analog-to-digital convert code. Add thread-safety functionality #10.
2021-02-05 Make BMI088 library thread-safe #10.
2021-02-05 Refactor gyro & acc sensor. Add thread-safety #10.
2021-02-05 Add thread-safety layer to SPI #10.
2021-02-05 Rename I2C to I2CBus to avoid naming ambiguities #10.
    [main.cpp]
2021-02-05 Fix missing and old includes #10.
    [definitions.h]
2021-02-05 Add OneWire thread-safety constructs #10.
2021-02-05 Refactor PWM Output generator libary and add thread-safety #10.
2021-02-05 Refactor real time clock libary and add thread-safety #10.
2021-02-05 Refactor DS18B20 temperature sensor library and add thread-safety #10.
2021-02-05 Refactor SSD1305 i2c display library and add thread-safety #10.
2021-02-05 Refactor SD card library and add thread-safety #10.
2021-02-05 Refactor gpio blink and hardware interrupt handler #10.
2021-02-09 Add initial implementation and demo task/integration for the PCF8574 device (incl interrupt handler) #25
2021-02-09 Add interrupt routine #25
2021-03-01 fix: PIN Integration into definitions.h
    [definitions.h, main.cpp]
2021-03-06 ESP32Huzza initial
2021-03-26 feat: indicators controller by buttons, ADC integration
2021-03-27 feat: read 4 analog values to simulate bat, pv, mo
    [u-i-diagrams.ods]
2021-04-07 CAN initial version
    - Added basic CAN functionality
    - Added documentation for the other CAN devices
2021-04-10 update prints
2021-04-12 Add initial implementation of the software serial interaction between the ESP32 and the external telemetry module.
2021-04-14 Add blocking serial input (#45)
    * Add DS1803 datasheet.
    * Add initial implementation of the DS1803 digital potentiometer.
    * Try fix release that does not exist anymore.
    * Temporarily fix (externally) broken build pipeline.
    * Fix and test ds1803 with actual hardware.
    * Add DS1803 datasheet.
    * Add initial implementation of the DS1803 digital potentiometer.
    * Fix and test ds1803 with actual hardware.
    * Add DS1803 datasheet.
    * Add initial implementation of the DS1803 digital potentiometer.
    * Fix and test ds1803 with actual hardware.
    * Add initial implementation of the DS1803 digital potentiometer.
    * Fix and test ds1803 with actual hardware.
    * Fix rebase bug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
    [definitions.h, main.cpp]
2021-04-14 Add ds1803 digital potentiometer support. (#28)
    * Fix and test ds1803 with actual hardware.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
    [definitions.h, main.cpp]
2021-04-17 fix: readd SD card flag
    [LocalFunctionsAndDevices.h]
2021-04-17 exclude local function and devices settings
2021-04-18 Start adding port/device assignments.
2021-04-26 Added pinout of the correct board
2021-04-26 Added pinout of the correct board to ReadMe
2021-05-03 Add device overview diagram.
2021-05-03 Add all devices as tables & pin assignments.
2021-05-03 Add pin assignment according to the definitions.h specification for the ESP32
2021-05-03 chore:add steering wheels pin assignment
2021-05-03 Added CAN Pins
    **Conflict on Pin 25 with GPIO:Interrupt**
2021-05-09 Update to device_diagram.svg
    - changed color of Display
    - Added third ADC
    - Added CAN Transceiver
    - Added Umot
2021-05-09 chore: update pinout wheel (IOEXT2)
2021-05-10 feat: set all io to in, remove dac from wheel
2021-05-13 Add missing activation macro.
    [LocalFunctionsAndDevices.h]
2021-05-14 fix indentificaton, prepare debug infos
    [LocalFunctionsAndDevices.h, definitions.h]
2021-05-15 Remove old config switch definitions.
2021-05-15 Add can bus speed as an option in definitions.h
2021-05-15 Switch to prettier github action
2021-05-16 Add Ubat sensing pin. Remove unused npm/prettier artifacts.
2021-06-05 WIP: Add cpp classes (#69)
    * Add template cpp class implementation.
    * do some more exersises
    * Convert template to abstract task class
    * Apply prettier and clang-format
    * Solved the issue of c function pointer passing from C++ member function to FreeRTOS xTaskCreate (needs to be merged)
    * Fix missing include
    * feat: try1 driver display to Cpp
    * add FSR and first version accel/recup control,
    add docu PCF8574, ADS1115 at steering wheel
    * spelling, add VCC value
    * Apply prettier and clang-format
    * resolve merge conflict
    [LocalFunctionsAndDevices.h, main.cpp]
2021-06-17 first working version (DriverDisplay converted)
2021-07-01 fix: move enums out of class DriverDisplayC
    [main.cpp]
2021-07-11 Convert flat c to cpp classes (#80)
    * Move and refactor local clang-format script
    * Refactor interfaces as an esp-idf component
    * Fix header include from the include directory
    * Convert analog to digital converter flat c code to cpp class #66
    * Re-add read_adc_acceleration_recuperation task #66
    * Fix address assignment #66
    * Convert CanBus from c to cpp #66
    * Convert OneWireBus from c to cpp #66
    * Convert DS temperature sensor from c to cpp #66
    * Convert SPIBus from c to cpp #66
    * Convert SDCard from c to cpp #66
    * Convert I2CBus from c to cpp #66
    * Convert CmdHandler from c to cpp #66
    * Convert DAC from c to cpp #66
    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
    [definitions.h, main.cpp]
2021-07-15 fix: init background with numbers 0 in display
    [LocalFunctionsAndDevices.h, definitions.h, main.cpp]
2021-07-15 fix: display of first numbers at position 2 to 4 fix: lifeSign blink
    [main.cpp]
2021-07-28 clean up
    [usb-jtag.cfg]
2021-08-07 chore: include ELT DCAD initial
    [ser4.kicad_pcb, ser4.sch]
2021-08-07 chore: split into multi sheets
    [MainComputer.sch, SteeringWheel.sch, ser4.sch]
2021-08-08 feat:split in moduls
    [MainComputer.sch, SandBox.sch, SteeringWheel.sch, ser4.kicad_pcb, ser4.sch]
2021-08-08 chore: add some info texts
    [MainComputer.sch, SteeringWheel.sch, ser4.sch]
2021-08-10 fix: DS1803
    [MainComputer.sch]
2021-08-10 chore: improve readme
    [MainComputer.sch, ser4.kicad_pcb]
2021-08-22 chore:assembly info PCF8574
2021-08-22 chore: assembly info PCF8574
2021-08-29 chore: data sheets and fixed schema
    [definitions.h]
2021-09-01 Add missing Prohelion BMS datasheets (CAN specs, ..)
2021-10-02 initial rework with new hardware
    [definitions.h]
2021-10-02 Add initial implementation of car speed pid control. (#107)
    * Add initial implementation of car speed pid control.
    * Fix variable name, fix integer arithmetic
    * Fix class function implementation: add missing CarSpeed::
    * Integrate CarSpeed class to FreeRTOS structure
    * Remove redeclaration, add abstract_class extension
    [LocalFunctionsAndDevices.h, main.cpp]
2021-10-02 Extend ioext multi dev (#105)
    * Rework IOExt to support multiple devices #86
    * Rework IOExt to support multiple devices #86
    * Add PCF8574 multi device addresses
    * Update from 3 to 4 devices
    * Print message not only upon error, but also report success.
    * Add legacy pin read support
    * Add missing comma.
    * Fix instance array size
    * Add unique dummy variables
    [definitions.h]
2021-10-10 add IO print to Status print
2021-10-16 refactor: remove instance() for DriverDisplay0
2021-10-25 - autofromat - engineer screen and driver screen - rtc integration (add ESP32Time lib) - CarControl initial
2021-10-25 imporve next-Button function
2021-10-25 switch indicator, light off at startup
2021-10-26 fix potentially math precedence problems
    [definitions.h]
2021-11-26 Feature/simplify-carstate (#120)
    * add speed calc
    * - order library in platform.ini alphabetically
    - feat: SD-Card ser4 boot conform, reduce outputs
    - feat: RTC ser4 boot conform
    - fix: delete wrong paste data
    - allow init SPI
    - fix: names fixed, formatting fixed
    * - remove wrong include
    * - reduce flickering on display start
    - move some functions in display base class
    * stabalized display :)
    * clean up all the stuff,
    use new semaphoreTake that can throw exception,
    make tft static
    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
    [DisplayValue.h, LocalFunctionsAndDevices.h, definitions.h, main.cpp]
2021-12-05 remove all char buffers, remove lots of printf calls, refactor paddle_adjust
2021-12-05 add setting of potentiometer, add button and handler for adjust paddels
2021-12-20 fix pin 36 -> 32in docu
2021-12-23 Fix formatting and hope for the best during build.. (#130)
    * Fix formatting and hope for the best during build..
    * Use exact library version
    * Downgrade BusIO to compatible version
    [LocalFunctionsAndDevices.h]
2021-12-27 Move motor efficiency curve to dedicated folder
    [350R70V.CSV, 470R100V.CSV, 470R110V.CSV, 470R120V.CSV, 470R80V.CSV, 470R90V.CSV, 560R110V.CSV, 570R100V.CSV]
2021-12-27 Move motor efficiency curves to dedicated folder
    [470R100V.CSV, 470R110V.CSV, 470R120V.CSV, 470R80V.CSV, 470R90V.CSV, 560R80V.CSV, 570R100V.CSV, 570R110V.CSV]
2022-01-04 CAN rebase (#131)
    * Added CANPacket Class and RX Logic
    - Added new CAN Library
    - Added CANPacket Class
    - Added basic CAN receiving logic
    * Added Input Buffer for CAN
    - Added CANRxBuffer Class
    Doesn't compile because non relevant part of the CAN library uses instructions not that are not available.
    Maybe forking CAN library and removing said part?
    * Added abstract_task implementation to CANBus
    Implemented the abstract_task interface for CANBus
    * Reading MPPT and BMS data, CAN library fork
    - Added the possibility to read single bits as bool from CAN packet
    - Added code in comments to read MPPT and BMS data
    - Created fork of CAN library and deleted unnecessary parts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
    [definitions.h, main.cpp]
2022-01-12 Feature/adjust ios (#140)
    * update README
    * add csv writer to sd card
    * feat: break pedal switch acc to 0 and dec to max
    * initial Checklist.md,
    remember current speed and power
    * fix spelling and clean up old code,
    prepare memory dump,
    rename log file to .csv,
    set i2c clock to 200MHz,
    set default sleep time to 300ms,
    add formatted getTimeStamp for uptime display,
    * fix spelling, cleanup,
    set default sleep to 300ms,
    set i2c clock to 200MHz,
    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
    [SER4DATA.CSV]
2022-01-23 Added max age and filter for CAN Frames
    - Added functionality to update data from certain frames in a reduced interval
    - Added functionality to filter certain frames
    - Added corresponding definitions in definitions.h
2022-02-07 Switch SER fork & housekeeping (#149)
    * Add separate acceleration and deceleration output setpoints #138
    * Fix library include & formatting
    * Fix formatting
    * Replace platform_package (arduino-esp32 framework) from my personal to the forked solarenergyracers fork
    * Add linux and python virtual environment setup script.
    * Remove unused datasheets
    * Keep pdf datasheets only
    * Remove commented out code
    * Keep pdf datasheets only
    * Add template to add documentation
    * Add missing package
    * Source env again before run
    * Remove duplicates and rename datasheet consistently
2022-02-07 Add separate acceleration and deceleration output setpoints (#148)
    * fix merge mistake,
    add extern deklaration for ESP32SJA1000Class CAN
    * merge,
    set console speed to 9600
    some minor fixes
    * initial PID
    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
    [LocalFunctionsAndDevices.h, definitions.h, main.cpp]
2022-02-07 new sterring wheel controls (preview)
2022-02-07 lock dac motor setting to 0 until paddles adjusted
2022-02-13 Fix formatting to pass all ci pipelines. Test ci pipeline protected branch enforcement (#155)
    [LocalFunctionsAndDevices.h]
2022-02-14 Feature/show-target-speed (#158)
    * new sterring wheel controls (preview)
    * clean up
    * clean up
    * lock dac motor setting to 0 until paddles adjusted
    * add sdCardDetect
    * chore: update HW changes
    chor: doc for xbee integration
    * prepare integration for xbee (HW)
    * accelerator lock works
    * hide "locked" info on engineering screen
    * add target speed/value display
    * feat: safety: on delay turn off const mode off
    * format all
    * fix types for targetpower, targetfloat
    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
    [DisplayValue.h, main.cpp]
2022-02-14 Feature/reference-solar-cell (#162)
    * add comment markers for #SAVETY# relevant code
    * add docs and datasheets
    * feat: PV reference cell in carState
    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
2022-02-15 CANBus-CarState interaction
    Added primary CAN Bus data to CarState
2022-02-23 Adjusted output of Battery Errors
    Added option for a verbose and non-verbose output of battery errors.
2022-03-23 Feature/serial-radio-console (#168)
    * initial docu with working demo code
    * prepareation steps for HC-12
    * initial: serial radio communication
    * querry overload
    * first try Console usage with Serial, Serial2, HC-12
    * intermideate state: both displays running
    * readio consol part2
    * new pin layout steeringwheel,
    handling with +- const. value
    * Fix capitalization
    * first part of adoptions after review
    * first part of adoptions afer review
    * fix after review
    * fix formatting
    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
    [LocalFunctionsAndDevices.h, debugprint.h, definitions.h, main.cpp]
2022-03-24 Remove this-> in CANBus.cpp
2022-03-29 Replace manually set version numbers with current branch and commit hash.
    [definitions.h, main.cpp]
2022-03-30 Code refactoring (#179)
    * Set static version
    * Dead code removal
    * Add header
    * Remove unnecessary includes
    * Fix formatting artifacts
    * Standardize std usage
    * Fix formatting artifacts
    * Resolve all mentioned issues in the thread
    [CarStatePin.h, LocalFunctionsAndDevices.h, debugprint.h, main.cpp]
2022-03-30 Feature/serial radio console (#180)
    * buffered serial2 transfer (commented out)
    * fix: removing of extended chars from Serial2
    fix: cleanup Console usage
    fix: syntax error (char instead of string)
    * all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
    [LocalFunctionsAndDevices.h, main.cpp]
2022-03-31 feat: warning for about wrong PID value feat: initial ini file reader
2022-04-14 use CarDataLogPeriod and I2CFrequency
