SolarEnergyRacers/solar_car_control_system/(notices)

Notices in the files:
README.md:
License: GPL v3
